jjd408/solitaire/hw/sol/sol.kicad_pcb

## KiCad design hw/sol/sol.kicad_pcb (2026-11-13)

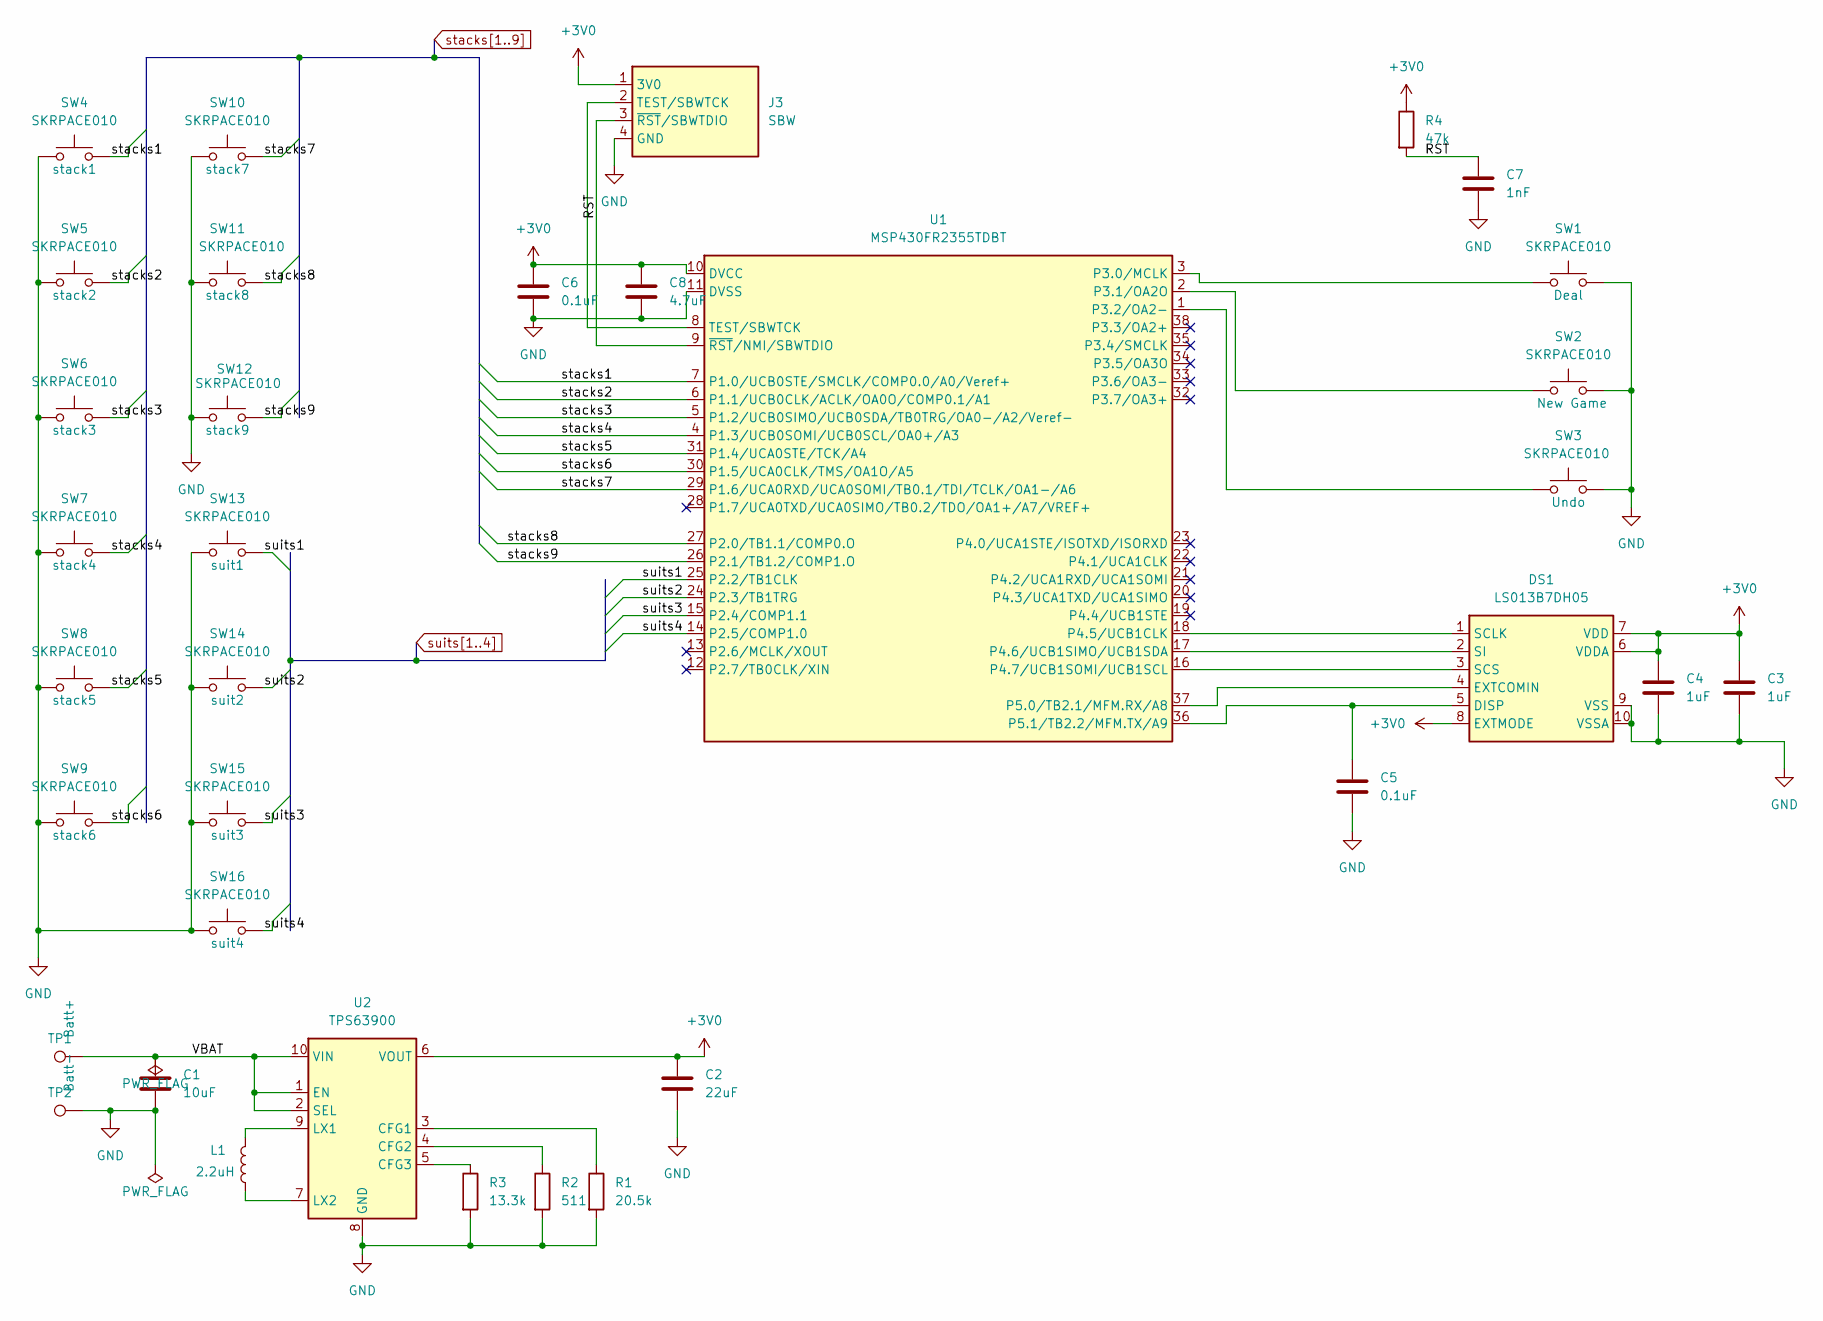
[picture p1: schematic sol.kicad_sch]

Parts:
C1: 10uF; C_0603_1608Metric; MPN GRM188R60J106ME47
C2: 22uF; C_0603_1608Metric; MPN GRM187R60J226ME15
C3, C4: 1uF; C_0603_1608Metric; MPN GRM188R71A105KA61
C5, C6: 0.1uF; C_0603_1608Metric; MPN GRM188R71C104KA01
C7: 1nF; C_0603_1608Metric; MPN GRM188R71H102KA01
C8: 4.7uF; C_0603_1608Metric; MPN GRM188R60J475KE19
DS1: LS013B7DH05; Panasonic_AYF531035_1x10-1MP_P0.5mm_Horizontal
J3: SBW; PinHeader_1x04_P2.54mm_Vertical
L1: 2.2uH; L_Murata_DFE201612E; MPN DFE201612E-2R2M=P2
R1: 20.5k; R_0603_1608Metric; MPN RC0603FR-0720K5L
R2: 511; R_0603_1608Metric; MPN RC0603FR-07511RL
R3: 13.3k; R_0603_1608Metric; MPN RC0603FR-0713K3L
R4: 47k; R_0603_1608Metric; MPN RC0603FR-0747KL
SW1: SKRPACE010; SW_Alps_SKRPACE010; MPN Deal
SW2: SKRPACE010; SW_Alps_SKRPACE010; MPN New Game
SW3: SKRPACE010; SW_Alps_SKRPACE010; MPN Undo
SW4: SKRPACE010; SW_Alps_SKRPACE010; MPN stack1
SW5: SKRPACE010; SW_Alps_SKRPACE010; MPN stack2
SW6: SKRPACE010; SW_Alps_SKRPACE010; MPN stack3
SW7: SKRPACE010; SW_Alps_SKRPACE010; MPN stack4
SW8: SKRPACE010; SW_Alps_SKRPACE010; MPN stack5
SW9: SKRPACE010; SW_Alps_SKRPACE010; MPN stack6
SW10: SKRPACE010; SW_Alps_SKRPACE010; MPN stack7
SW11: SKRPACE010; SW_Alps_SKRPACE010; MPN stack8
SW12: SKRPACE010; SW_Alps_SKRPACE010; MPN stack9
SW13: SKRPACE010; SW_Alps_SKRPACE010; MPN suit1
SW14: SKRPACE010; SW_Alps_SKRPACE010; MPN suit2
SW15: SKRPACE010; SW_Alps_SKRPACE010; MPN suit3
SW16: SKRPACE010; SW_Alps_SKRPACE010; MPN suit4
TP1: Batt+; TestPoint_THTPad_2.0x2.0mm_Drill1.0mm
TP2: Batt-; TestPoint_THTPad_2.0x2.0mm_Drill1.0mm
U1: MSP430FR2355TDBT; TSSOP-38_4.4x9.7mm_P0.5mm
U2: TPS63900; WSON-10-1EP_2.5x2.5mm_P0.5mm_EP1.2x2mm_ThermalVias

Connections:
+3V0: C2.1, C3.1, C4.1, C6.1, C8.1, DS1.6 (VDDA), DS1.7 (VDD), DS1.8 (EXTMODE), J3.1 (3V0), R4.1, U1.10 (DVCC), U2.6 (VOUT)
/RST: C7.1, J3.3 (~RST/SBWTDIO), R4.2, U1.9 (~RST/NMI/SBWTDIO)
/VBAT: C1.1, TP1.1, U2.1 (EN), U2.2 (SEL), U2.10 (VIN)
GND: C1.2, C2.2, C3.2, C4.2, C5.2, C6.2, C7.2, C8.2, DS1.9 (VSS), DS1.10 (VSSA), J3.4 (GND), R1.2, R2.2, R3.2, SW1.2, SW2.2, SW3.2, SW4.1, SW5.1, SW6.1, SW7.1, SW8.1, SW9.1, SW10.1, SW11.1, SW12.1, SW13.1, SW14.1, SW15.1, SW16.1, TP2.1, U1.11 (DVSS), U2.8 (GND), U2.11 (GND)
unnamed: C5.1, DS1.5 (DISP), U1.36 (P5.1/TB2.2/MFM.TX/A9)
unnamed: DS1.4 (EXTCOMIN), U1.37 (P5.0/TB2.1/MFM.RX/A8)
unnamed: DS1.1 (SCLK), U1.18 (P4.5/UCB1CLK)
unnamed: DS1.3 (SCS), U1.16 (P4.7/UCB1SOMI/UCB1SCL)
unnamed: DS1.2 (SI), U1.17 (P4.6/UCB1SIMO/UCB1SDA)
unnamed: J3.2 (TEST/SBWTCK), U1.8 (TEST/SBWTCK)
unnamed: SW1.1, U1.3 (P3.0/MCLK)
unnamed: SW2.1, U1.2 (P3.1/OA2O)
unnamed: SW3.1, U1.1 (P3.2/OA2-)
unnamed: R1.1, U2.3 (CFG1)
unnamed: R2.1, U2.4 (CFG2)
unnamed: R3.1, U2.5 (CFG3)
unnamed: L1.2, U2.9 (LX1)
unnamed: L1.1, U2.7 (LX2)
stacks1: SW4.2, U1.7 (P1.0/UCB0STE/SMCLK/COMP0.0/A0/Veref+)
stacks2: SW5.2, U1.6 (P1.1/UCB0CLK/ACLK/OA0O/COMP0.1/A1)
stacks3: SW6.2, U1.5 (P1.2/UCB0SIMO/UCB0SDA/TB0TRG/OA0-/A2/Ve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)
stacks4: SW7.2, U1.4 (P1.3/UCB0SOMI/UCB0SCL/OA0+/A3)
stacks5: SW8.2, U1.31 (P1.4/UCA0STE/TCK/A4)
stacks6: SW9.2, U1.30 (P1.5/UCA0CLK/TMS/OA1O/A5)
stacks7: SW10.2, U1.29 (P1.6/UCA0RXD/UCA0SOMI/TB0.1/TDI/TCLK/OA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)
stacks8: SW11.2, U1.27 (P2.0/TB1.1/COMP0.O)
stacks9: SW12.2, U1.26 (P2.1/TB1.2/COMP1.O)
suits1: SW13.2, U1.25 (P2.2/TB1CLK)
suits2: SW14.2, U1.24 (P2.3/TB1TRG)
suits3: SW15.2, U1.15 (P2.4/COMP1.1)
suits4: SW16.2, U1.14 (P2.5/COMP1.0)

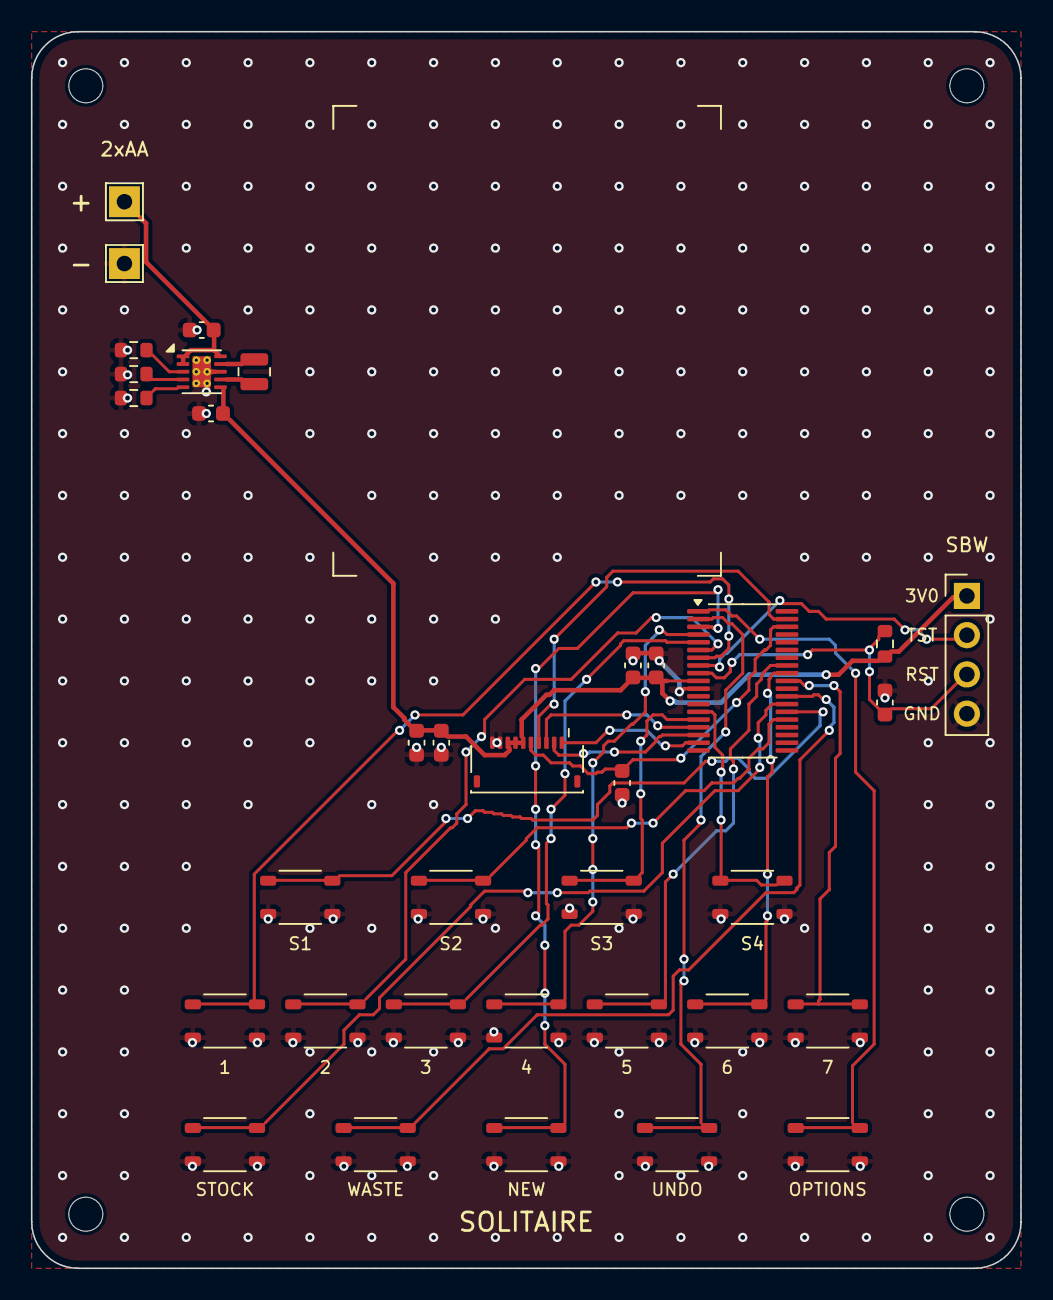
[picture p2: board sol.kicad_pcb from above]

Board: 2 copper layers, 64.0 x 80.0 mm, 40 parts (0 on the bottom side), 31 nets.

Other parts of the board:
H1, H2, H3, H4: MountingHole_2.2mm_M2
LCD1: LS013B7DH05; LCD_Sharp_LS013B7DH05_Outline
