jjd408/solitaire/(commit log)

2026-11-03 Solitaire handheld hardware: KiCad project, library and datasheets
    The KiCad 9 schematic (passes ERC) and PCB in progress, the project's
    generated symbol/footprint/3D library, design notes, and the datasheets the
    parts were built from. The library tables now use project-relative paths,
    and the button footprint finds its 3D model beside the project folder.
2026-11-04 Lay out and route the board
    64 x 80 mm, two layers, all parts on the front: the display face up with its
    FPC straight into the connector, the MCU beside it, the power stage left of
    the display, and the buttons in the simulator's 4/9/3 rows. layout.py places
    everything; route.py routes it with a negotiated-congestion maze router, fans
    out and pours ground, and joins any ground pad left cut off. DRC is clean,
    including schematic parity.
    The display's glass and FPC outline is now a board-only footprint in the
    library, carrying its 3D model.
2026-11-05 Start the firmware: plan and NetBeans project
    sw/PLAN.md sets out the assembly firmware: what it drives, clocks and power
    (ACLK from REFO in low-power mode for EXTCOMIN, LPM3 between presses, no deep
    sleep), the event loop, interrupts, modules and calling conventions, the game
    kept in FRAM so it survives power loss, the display protocol and layout
    (including how tall columns squeeze to fit), buttons and controls, the options
    screen, Klondike data and undo, testing in the simulator, and milestones.
    sw/sol is the NetBeans MSP430 project, with a file per planned module. The
    README lists sw/ and notes that the PCB is routed.
2026-11-06 Firmware plan: keep the watchdog as a safety net
    The watchdog runs on ACLK with a 256 s time-out (not SMCLK, which would keep
    the DCO running in LPM3), is held during set-up and kicked on every pass of
    the main loop. TB0 becomes the time base at ACLK / 64: its overflow every 128 s
    wakes main to kick the watchdog while idle, and its CCR0 still times the
    button lockouts. Watchdog resets are counted with the statistics. Step 1 gains
    checks for no reset while idle and recovery from a hang.
2026-11-07 Firmware step 1: start-up, clocks, time base, watchdog and sleep
    system sets unused pins (and the pins the TSSOP-38 doesn't bring out) to
    outputs driven low, then releases LOCKLPM5; runs MCLK and SMCLK at 7.995 MHz
    from the FLL on REFO, with ACLK from REFO in low-power mode; starts TB0 as the
    time base at ACLK / 64, whose wrap every 128 s wakes main; and starts the
    watchdog on ACLK with a 256 s time-out. main kicks the watchdog and sleeps in
    LPM3. sol.h holds the shared register values. The other modules are stubs.
    Checked in the simulator: MCLK 7,995,392 Hz, asleep in LPM3, no reset over
    10 minutes of idle, and a hang reset by the watchdog.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
2026-11-09 Drive the display and show a test pattern, with its first automated test
    SPI on UCB1, EXTCOMIN at 60 Hz from TB2.1, the framebuffer and dirty-line
    bitmap, lcd_clear, and lcd_flush sending only the dirty lines. tests/run.sh
    builds the firmware, runs it on the simulator's display model and compares
    the screen with the approved picture.
2026-11-09 Firmware step 3: glyphs, cards, text and the card sheet test
    font.S holds a 5x7 font, the ranks and two sizes of suit as pixel art.
    gfx.S draws rectangles, glyphs, text, numbers, cards (whole or as a strip),
    backs, empty slots and selection anywhere on the screen, marking the lines
    it changes. main.S shows the card sheet; tests/run.sh checks it and step 2's
    pattern, each built with its own TEST_SCREEN.
2026-11-13 Plan step 4, the buttons, in its own doc
    Pins and roles, interrupts, the debounce on TB0 CCR0, the event queue,
    main's loop, the test screen and the press cases to test.
2026-11-13 Firmware step 4: button interrupts, debounce and the event queue
    The 16 buttons interrupt on a press; each press queues its role (sol.h) and
    locks the pin until it has read released on two 29 ms ticks of TB0 CCR0,
    so press and release bounce give one event. main sleeps until the queue
    has something and takes events from it. The test screen is still to come.
2026-11-13 Firmware step 4: the button test screen and its automated test
    A box per button with its event count, the latest filled, redrawn per event.
    tests/run.sh presses every button and the bounce, hold and two-at-once
    cases, and checks each press gives exactly one event and the chip sleeps.
2026-11-13 Move the waste and stock buttons to the bottom row
    Stacks 8 and 9 (SW11, SW12) leave the end of the stacks row for a bottom row
    of stock, waste, new, undo and options, matching the screen's stock and waste
    at the left. The pins are unchanged. The board is re-laid out and re-routed
    (DRC clean, schematic parity clean); the plan and docs describe the new rows.
2026-11-13 Add a 3x5 font and label every button on the test screen
    font.S gets a small font (digits and capitals) and gfx.S gfx_text_small,
    gfx_number_small and gfx_text_width_small. The button test screen lays its
    rows out as the board does, each box labelled over it and counted under it.
